smoluks/LCM3/docs/PCB/06_beultetve_drotozva.jpg

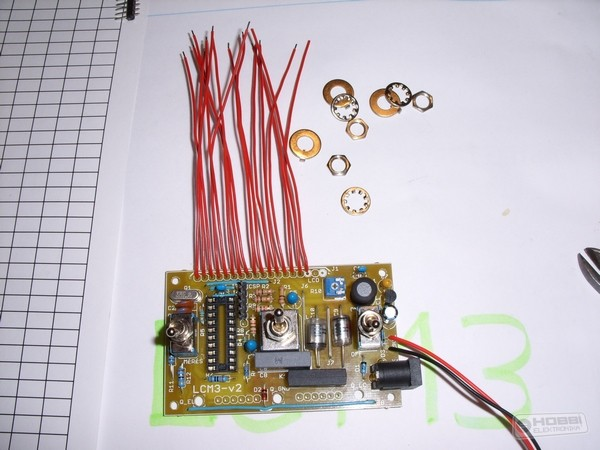
docs/PCB/06_beultetve_drotozva.jpg
