smoluks/LCM3/docs/photos/felul1.jpg

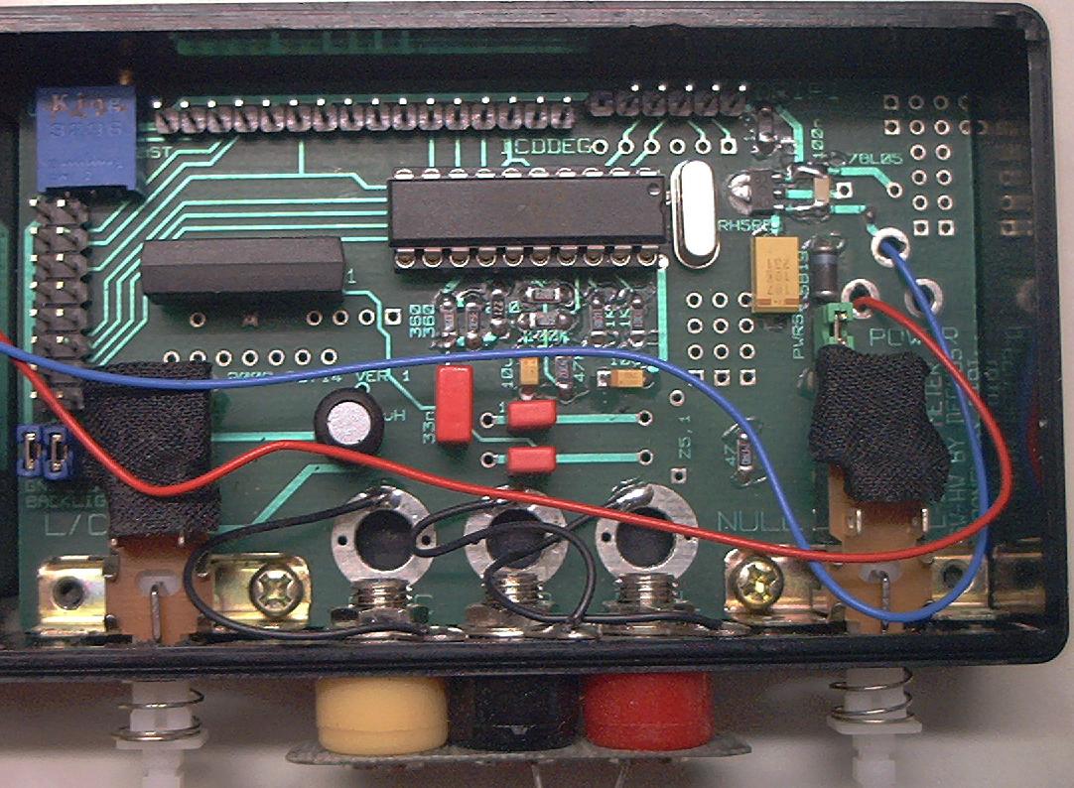
docs/photos/felul1.jpg
