smoluks/LCM3/README.md

# LCM3

Diptrace sch and pcb for Hungarian LC meter LCM3:
http://www.hobbielektronika.hu/kapcsolasok...seg_oldal1.html

Ru resource:
https://vrtp.ru/index.php?showtopic=19662&st=0
