smoluks/LCM3/atmega8/clone_schw.jpg

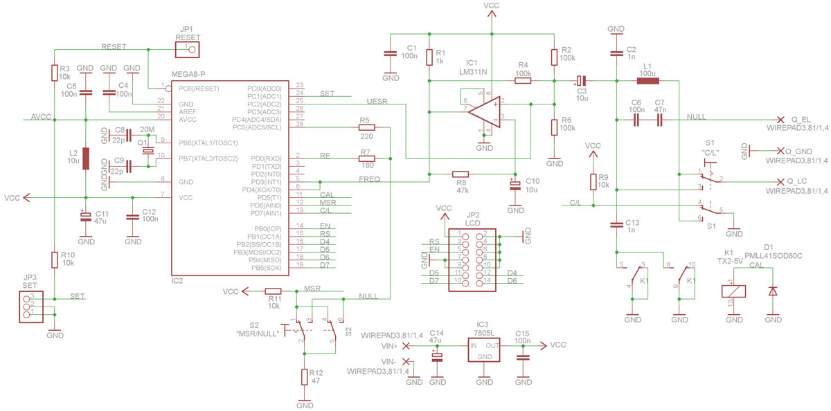
atmega8/clone_schw.jpg
