smoluks/LCM3/docs/275084828fd753a48701ff6f67b9c99d.jpg

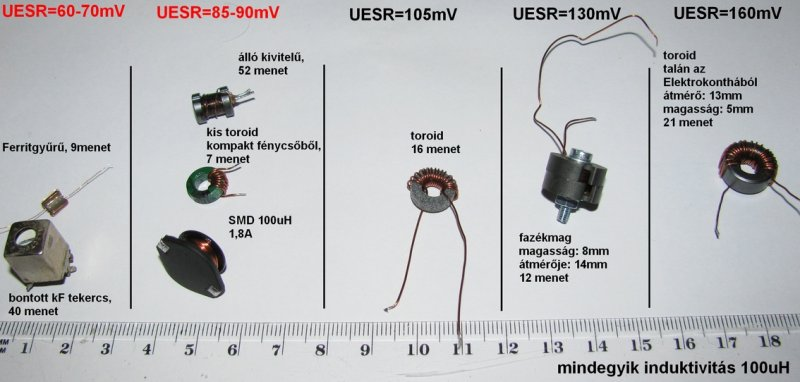
docs/275084828fd753a48701ff6f67b9c99d.jpg
