smoluks/LCM3/docs/analiz_snimok1.jpg

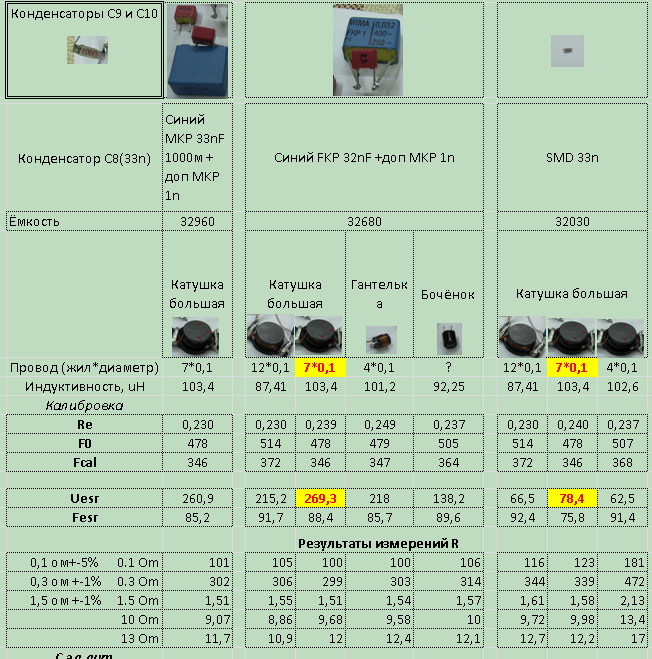
docs/analiz_snimok1.jpg
