smoluks/LCM3/docs/analiz_snimok2.jpg

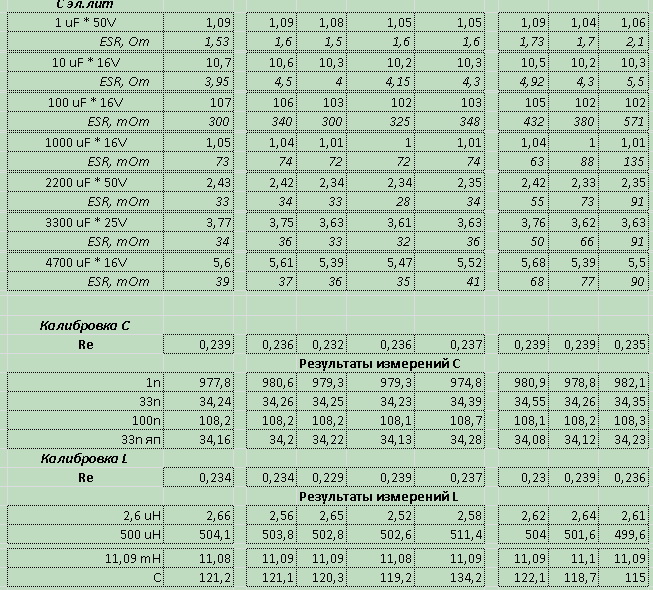
docs/analiz_snimok2.jpg
