smoluks/LCM3/docs/capacitor_value_vs_temperature_chart.gif

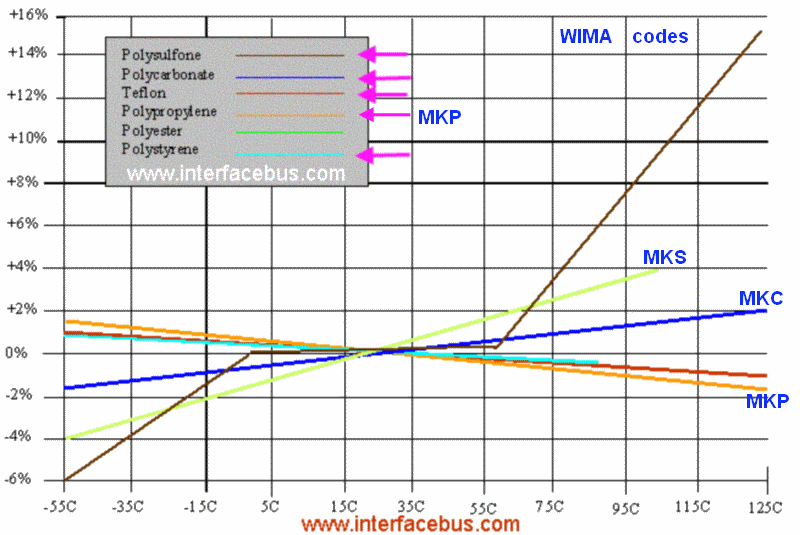
docs/capacitor_value_vs_temperature_chart.gif
