smoluks/LCM3/docs/lcm3_incircuit.png

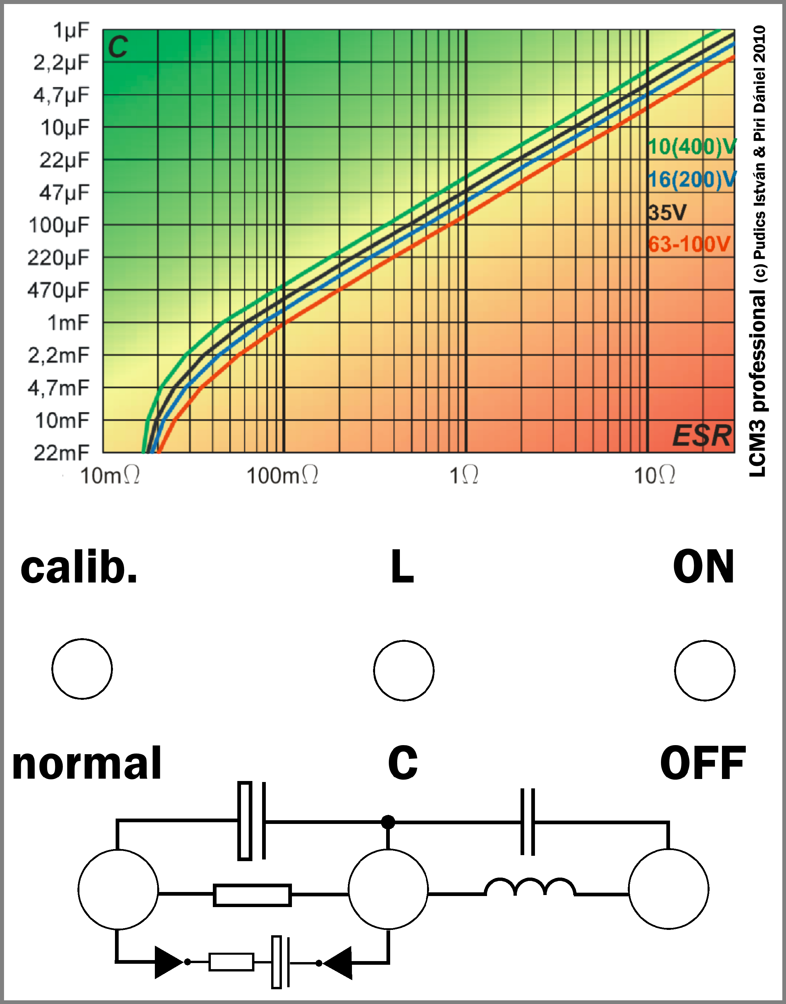
docs/lcm3_incircuit.png
