smoluks/LCM3/docs/PCB/00_nyak_elol.jpg

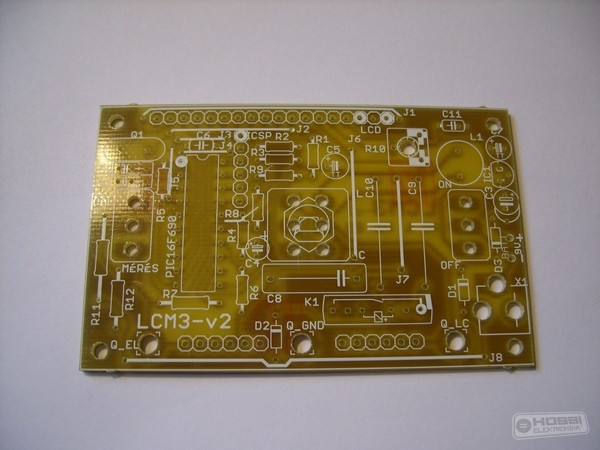
docs/PCB/00_nyak_elol.jpg
