smoluks/LCM3/docs/PCB/01_nyak_hatul.jpg

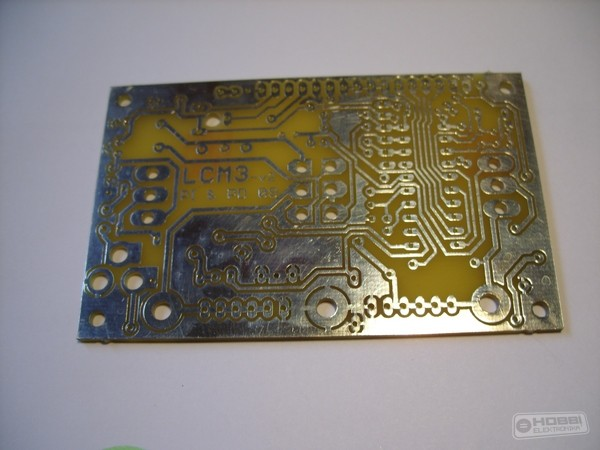
docs/PCB/01_nyak_hatul.jpg
