smoluks/LCM3/docs/PCB/lcm3_v2_board_sol.png

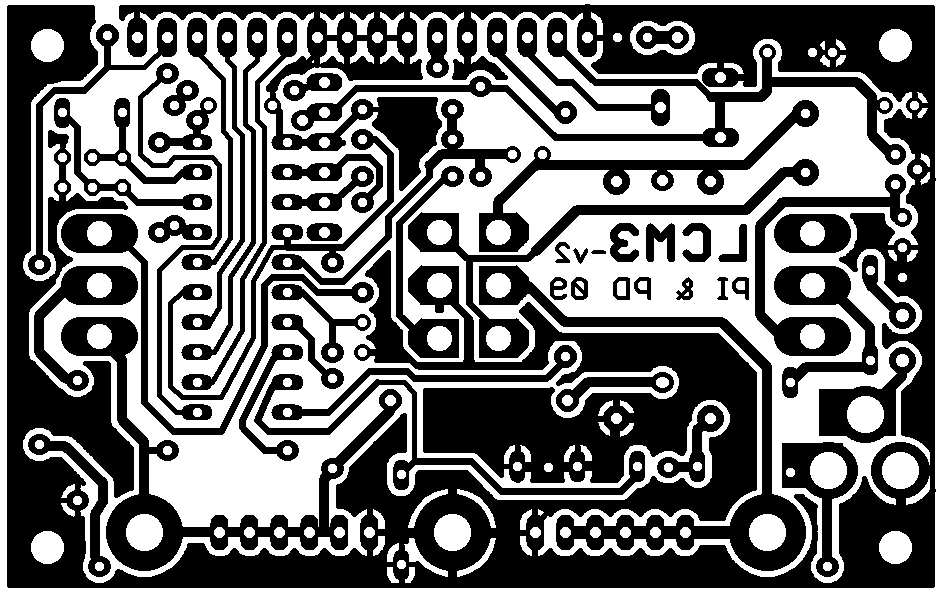
docs/PCB/lcm3_v2_board_sol.png
