smoluks/LCM3/docs/photos/12_bananhuvely_felul.jpg

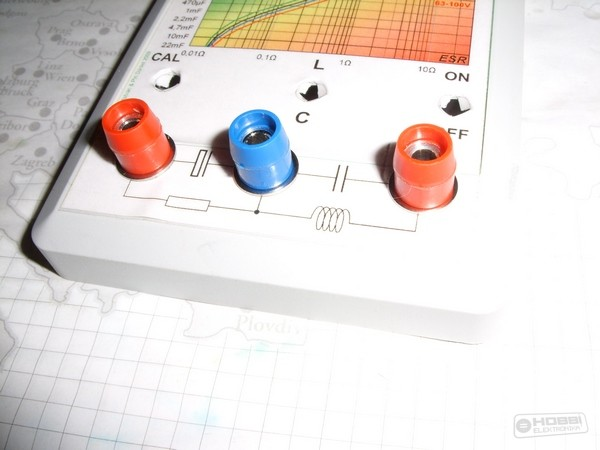
docs/photos/12_bananhuvely_felul.jpg
