smoluks/LCM3/docs/photos/14_reszlet_felfekszik.jpg

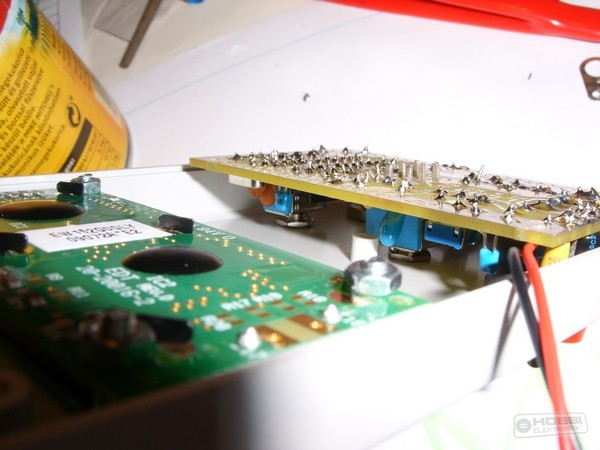
docs/photos/14_reszlet_felfekszik.jpg
