smoluks/LCM3/docs/photos/22_elem (1).jpg

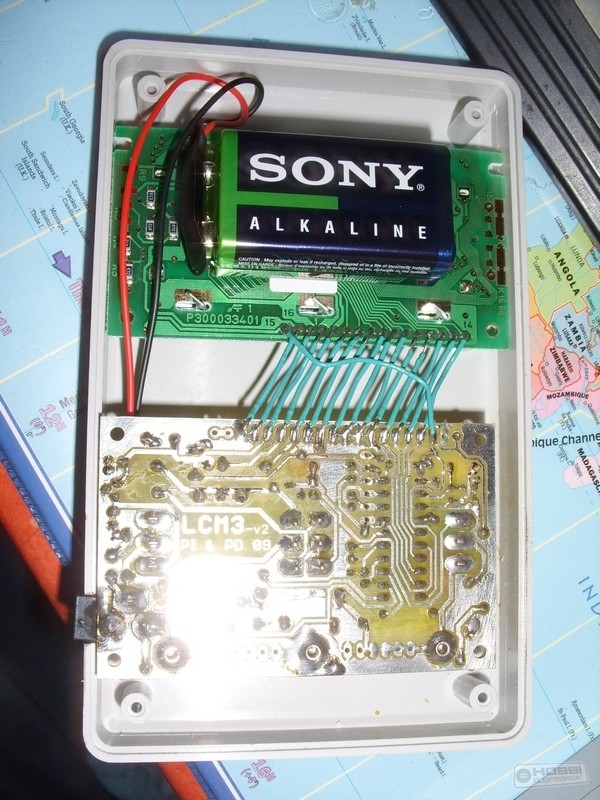
docs/photos/22_elem (1).jpg
