smoluks/LCM3/docs/photos/alul.jpg

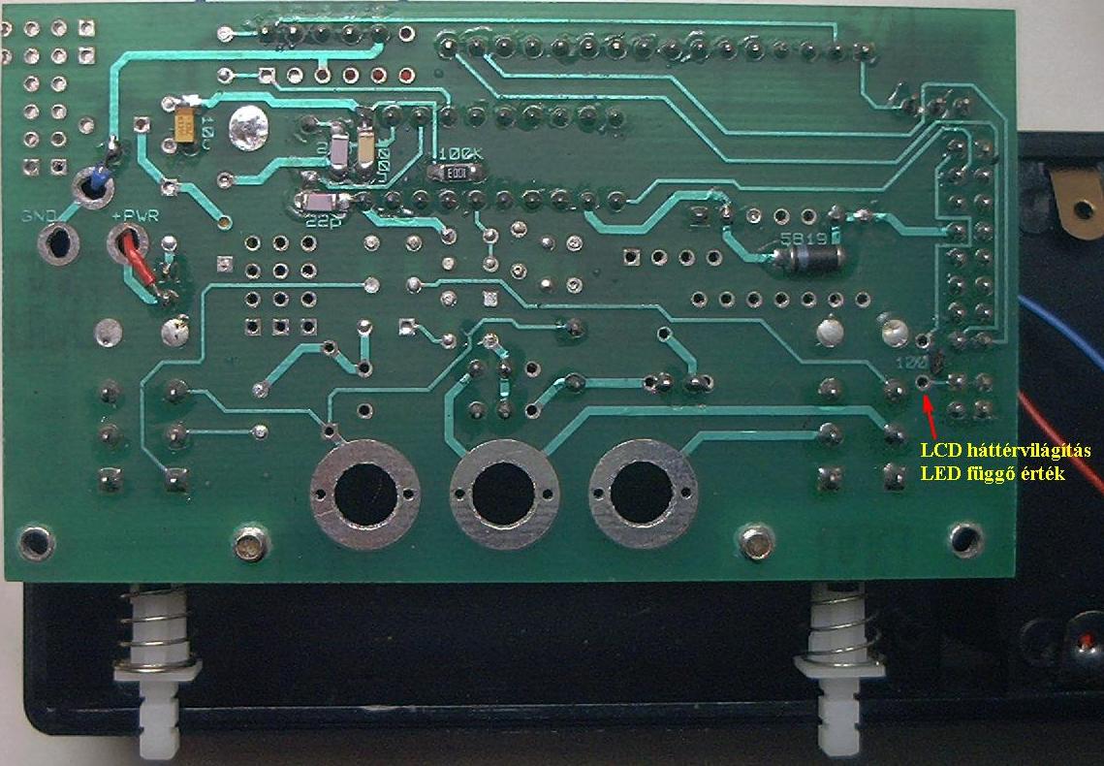
docs/photos/alul.jpg
