smoluks/LCM3/docs/photos/c_2003pf.jpg

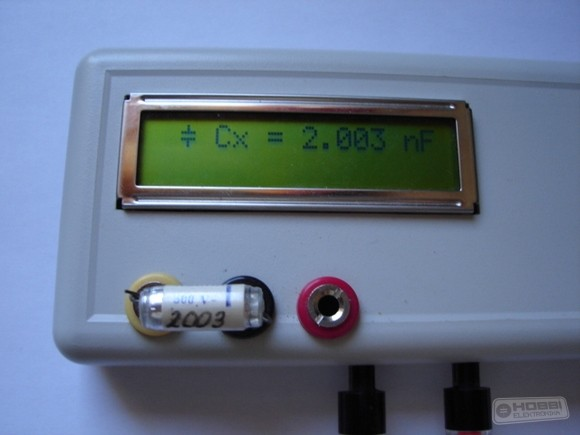
docs/photos/c_2003pf.jpg
