smoluks/LCM3/docs/photos/dobozban.jpg

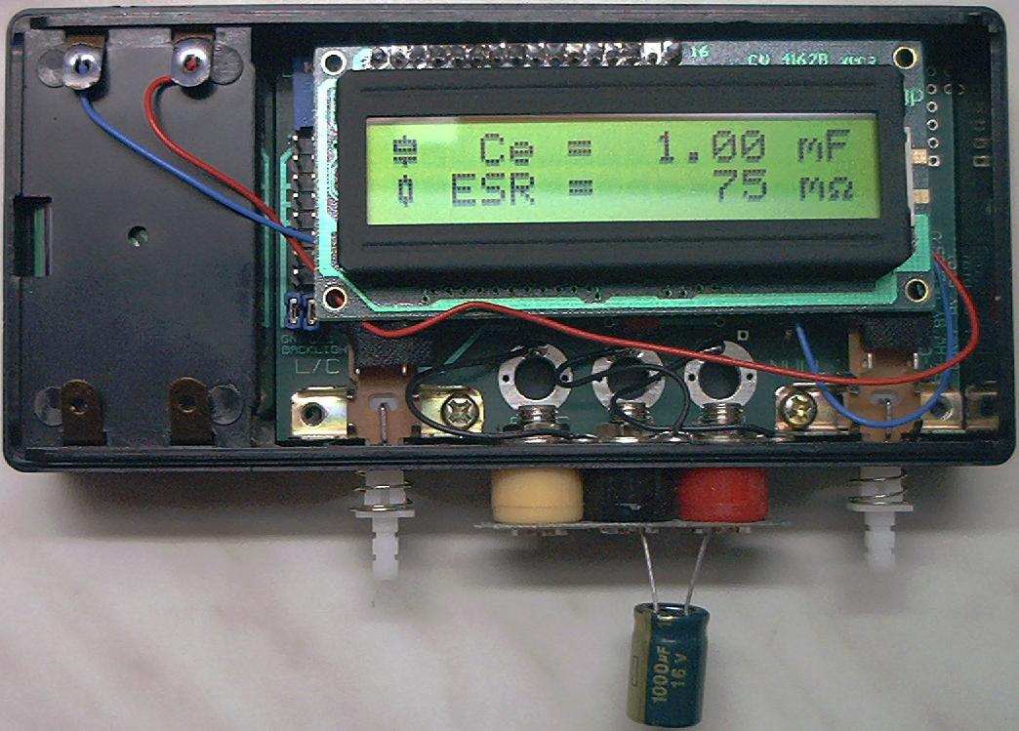
docs/photos/dobozban.jpg
