smoluks/LCM3/docs/photos/esr_tablazat.jpg

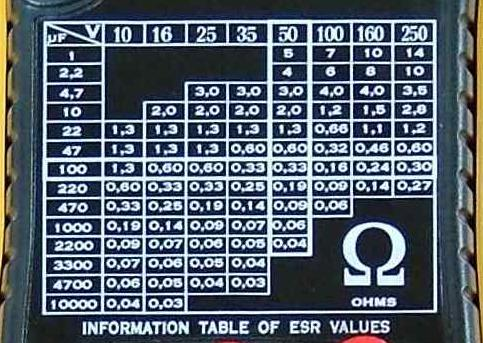
docs/photos/esr_tablazat.jpg
