smoluks/LCM3/docs/photos/felul2.jpg

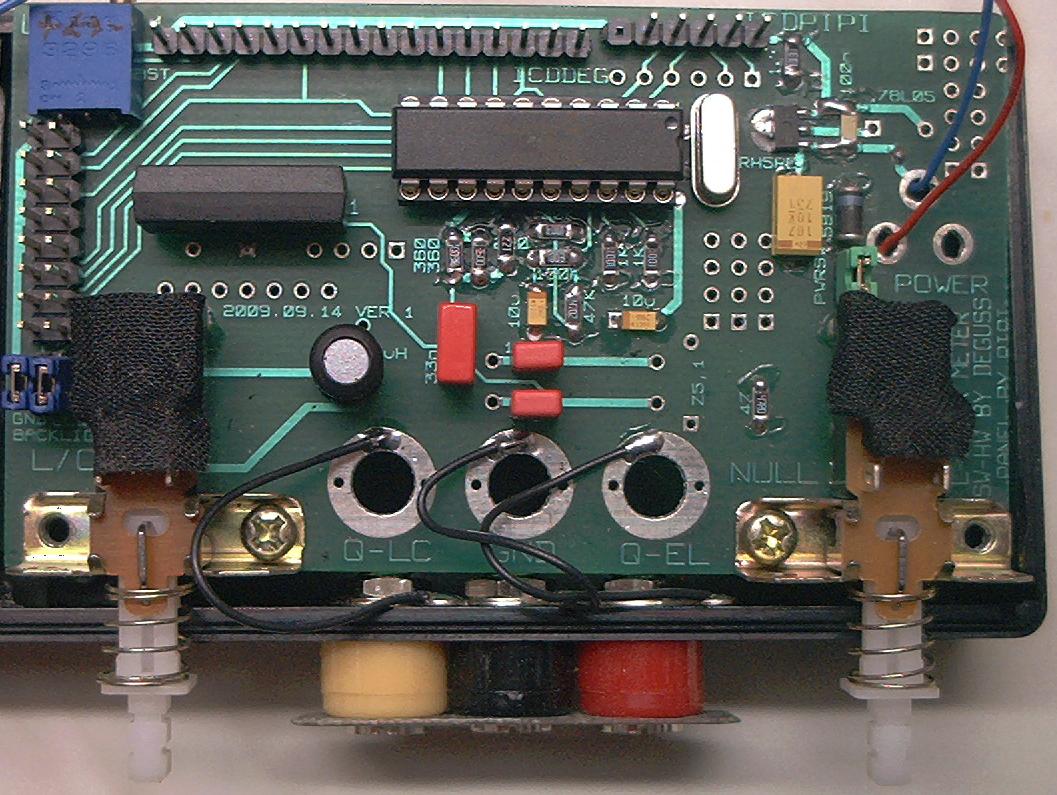
docs/photos/felul2.jpg
