smoluks/LCM3/docs/photos/mer_cp.jpg

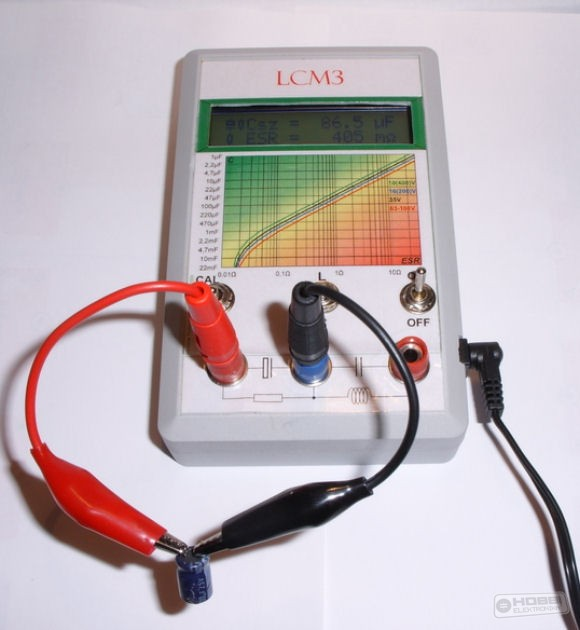
docs/photos/mer_cp.jpg
