smoluks/LCM3/docs/photos/oldal.jpg

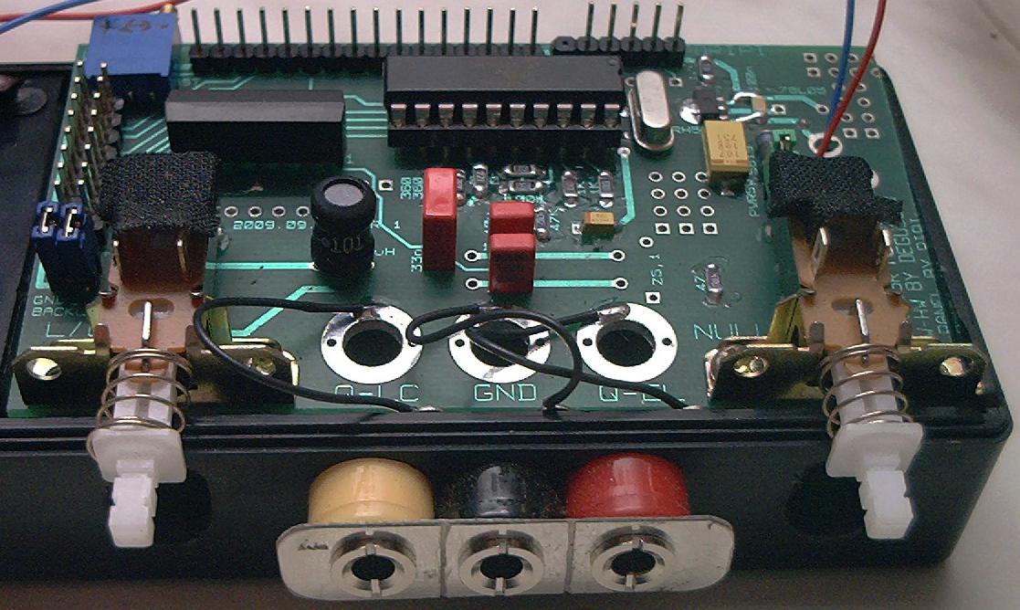
docs/photos/oldal.jpg
