smoluks/LCM3/docs/post-39-1330203417.jpg

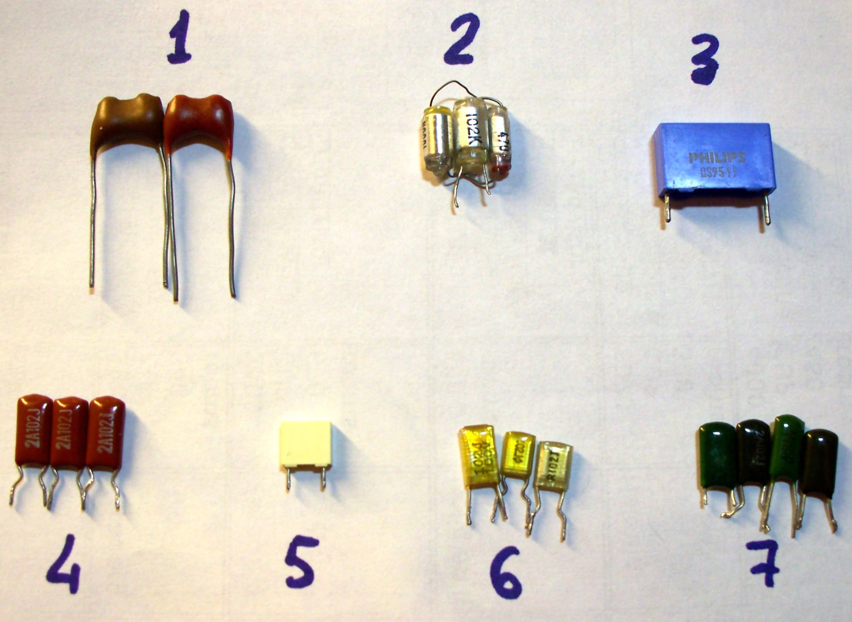
docs/post-39-1330203417.jpg
