smoluks/LCM3/docs/post-39-1334311889.jpg

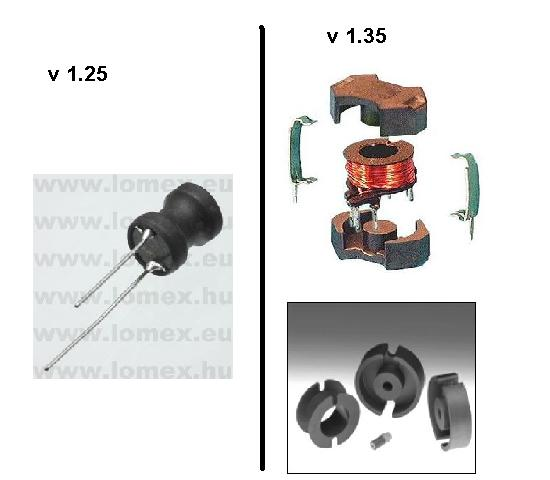
docs/post-39-1334311889.jpg
