smoluks/LCM3/docs/sch/Esr16F690BRD.gif

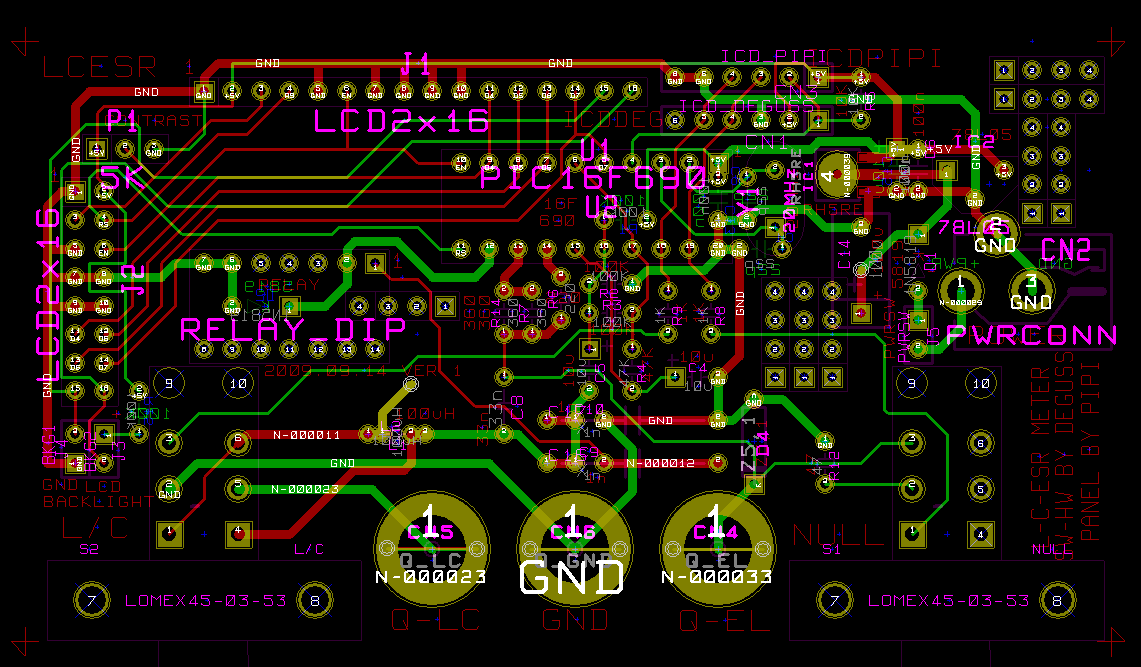
docs/sch/Esr16F690BRD.gif
