smoluks/LCM3/docs/sch/Esr16F690SCH.gif

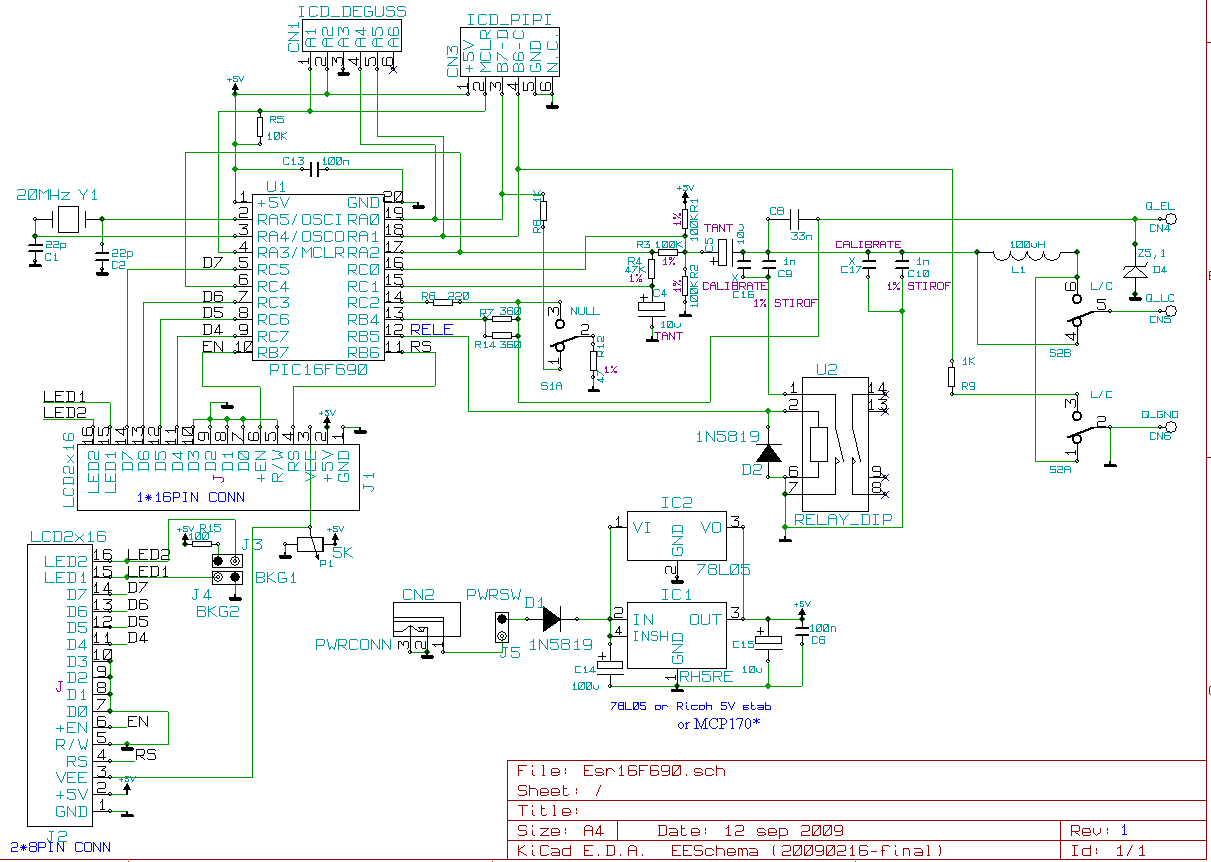
docs/sch/Esr16F690SCH.gif
