smoluks/LCM3/docs/sch/lcm3_v2_sch.png

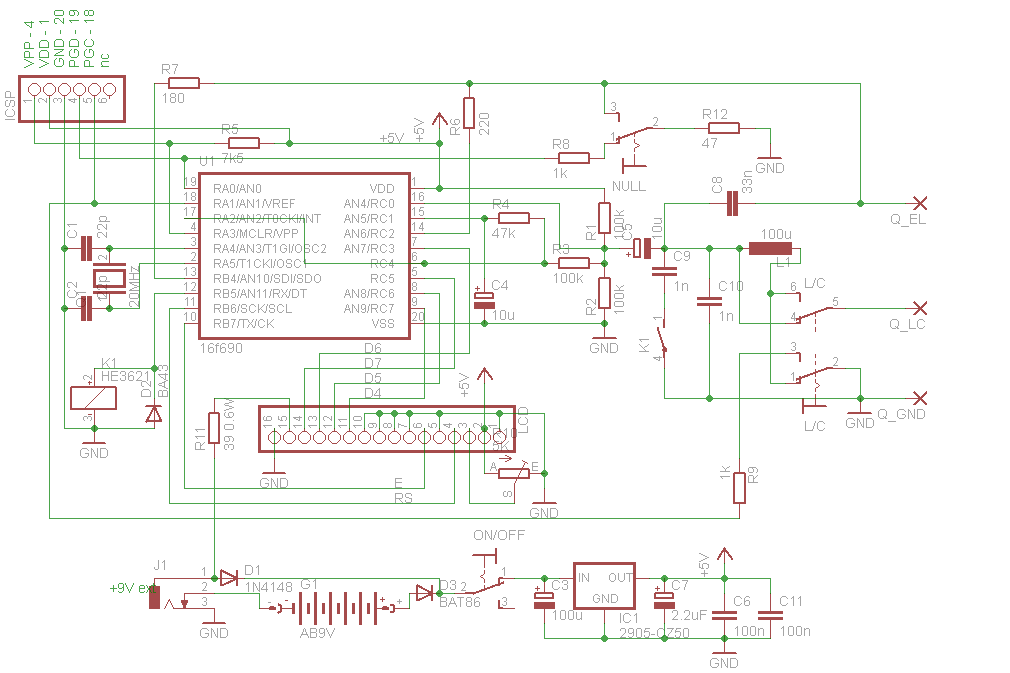
docs/sch/lcm3_v2_sch.png
