smoluks/LCM3/docs/sch/post-39-1329419530.jpg

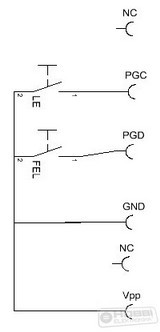
docs/sch/post-39-1329419530.jpg
