smoluks/LCM3/docs/sch/schematic_v1_eredeti.png

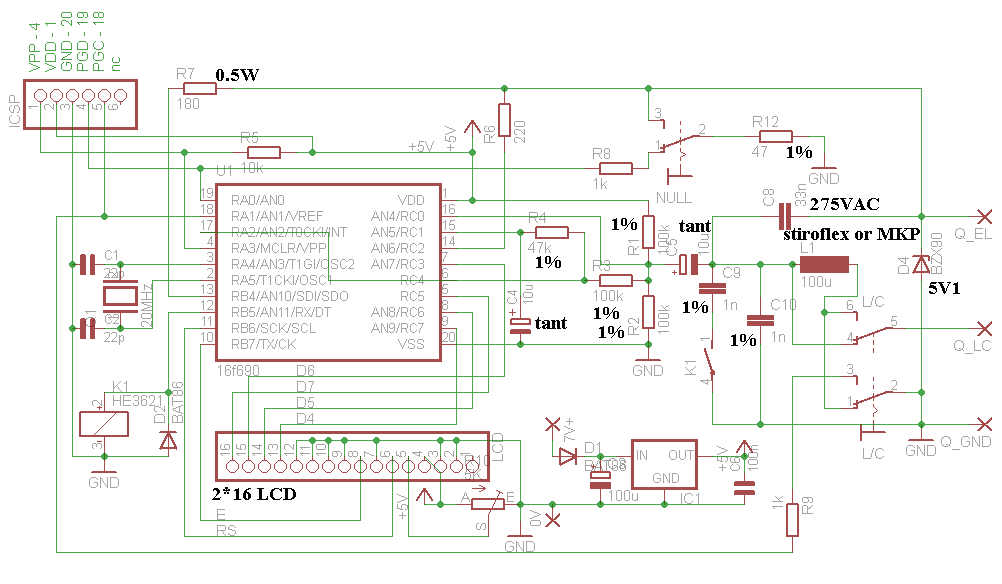
docs/sch/schematic_v1_eredeti.png
