smoluks/LCM3/docs/manuals/HU_LCM3v2.2.pdf

Használati utasítás | LCM3 v2 | 1

# LCM3

Az LCM3 egy mér
ı

m

őszer, mely segítségére lehet elektronikai alkatrészek megmérésében. Használata sokoldalú, különféle mérési feladatok ellátásánál tehet jó szolgálatot. Kezdve a tervezést

ıl, | a | min

ıségellen

ırzésen | és | alkatrészek
beazonosításán át a hibakeresésig. Az LCM3 egyben asztali m

őszer is, mivel m

őködtethet

ı dugasztápról is, megvilágított kijelz

ıvel. A gondos tervezésnek valamint a speciális alkatrészeknek köszönhet

ıen sokáig pontos, ismételhet
ı
méréséket lehet vele végezni, széls

ıséges körülmények között is.

A m

őszer paraméterei
- Kapacitásmérés 0,1pF-tól 0,1F-ig, (hitelesítés után 0,1pF-200nF között 1% pontosság egyébként e felett is 2,5%). Két tartományban: a jobb oldali csatlakozón 1uF-ig, a bal oldalin 500nF-tól.
- Induktivitásmérés 10nH-t
ıl 20H-ig, hitelesítés után 5%.
- Elektrolit kondenzátorok soros veszteségi ellenállását (ESR), illetve bármilyen kis ellenállást (<30 Ohm) mér, 5 ezred Ohm felbontással, (hitelesítés után 5% 500mOhm alatt, e felett 10%).
- E mellett képes egy tekercs (kb. 2-90mH) kapacitásának megmérésére is az induktivitás folyamatos mérése közben, és még pár apróságra, mint pl. szivárgó vagy zárlatos kondenzátorok felismerésére…

M

őködés, használat

Kapcsoljuk be a m

őszert. Ha tekercset szeretnénk mérni, váltsuk át a középs

ı kapcsolót L módba. Ellen

ırizzük, hogy közel 0 pF
illetve 0 uH (induktivitás mérésnél rövidre zárt bemenet esetén) a kimutatott érték. Ha nem, akkor kalibráció szükséges (lsd. lentebb). A mérend

ı alkatrészt a dobozon jelölt ábrának megfelel

ıen csatlakoztassuk a csipeszekkel. A mért értékek megjelennek a kijelz

ın.

Els

ı használatbavétel / Kalibráció

Els

ı használatbavételkor az ellenállásmérés (ESR) kalibrációja szükséges. Bekapcsoláskor a kapacitásmérés automatikusan megtörténik, de mind három módban lehet kalibrálni.

- C nullázás
Tegyük be a két mér

ıkábelt kondenzátor méréséhez, a középs

ı és a jobb oldali csatlakozókba. Váltsuk át a bal oldali CAL feliratú kapcsolót, várjunk míg megjelenik, hogy visszaválthatjuk és akkor értelem szer

ően váltsuk vissza
alaphelyzetbe (alsó állás).
A m

őszer pár diagnosztikai értéket kiír, majd rövidesen újra mérésre készen áll, és 0pF-ot fog mutatni.
- L nullázás
(Akkor fontos, ha kis induktivitásokat szeretnénk mérni <1mH) Tegyük be a két mér

ıvezetéket a tekercs
szimbólummal jelölt kivezetésekhez, és zárjuk azokat össze! A kalibráló kapcsolót váltsuk CAL állásba, és várjuk meg, míg a felirat megjelenik, majd váltsuk vissza.
- ESR nullázás
Tegyük be a két mér

ıvezetéket az ellenállás
szimbólummal jelölt kivezetésekhez, és zárjuk azokat össze, ügyelve a szoros érintkezésre. Ajánlott a mindkét csipeszt egy mérend

ı alkatrésze egy azon lábára, szorosan egymás mellé csíptetni, így várhatóan méréskor is közel egyforma átmeneti ellenállások lépnek majd fel, és pontosan tudunk vele mérni. Nagyon fontos, hogy helyes értékkel (max +/- 10mOhm) mentsük el a rövidre zárt

Használati utasítás | LCM3 v2 | 2

mérıvezetéket, különben minden további ellenállásmérés
hamis lesz.
Ha a kalibrálás végével nem közel nullát mutat a rövidre
zárt vezetékekkel, akkor ismételjük meg a kalibrációt. Természetesen ezeket az értékeket megjegyzi a mőszer kikapcsolás vagy elemcsere után is.

A kalibráló kapcsoló visszaváltása után, mindenképpen várjunk addig az alkatrész mérésével, amíg nem jelenik meg a kijelzın újra a mért érték, ideális esetben 0.

Nem ajánlott …

- Feszültség alatt lévı alkatrészeket mérni.
- Ismeretlen feszültségre töltött, (vagy töltıdött) kondenzátorokat csatlakoztatni. (ki kell sütni!)
- Külsı feszültséget vezetni a mőszerbe.
- Hosszú mérıvezetékeket használni.
- Olcsó, megbízhatatlan elemet behelyezni, mivel a vacak kifolyik egy pár év után és szétmarja a mőszert.

A mőszer sztatikus feltöltıdésre érzékeny alkatrészeket tartal– maz! A kijelzıt és az IC-ket csak megfelelı körülmények között, földelt fóliás asztalon, ill. kellı körültekintéssel szereljük be.

Tápellátás

A mőszer nagyon keveset fogyaszt, mindössze
8-10mA-t. Így egy 9V-os tartós (alkáli) elemrıl is sokáig mőködik. Ha szeretnénk élvezni a háttér– világítás nyújtotta elınyöket, akkor csatlakoztassunk egy 7-10V közötti egyenirányított tápegységet.

A csatlakozó polaritásvédett, 5.5 / 2.1mm átmérıjő dugóval használható.
(Ha valaki 12V-os tápegységet szeretne használni, cserélje R11-et 39Ohmról legalább 50Ohm/1W-ra, megelızve a háttérvilágítás túlhajtását; egyébként minden más maradhat max. 15V tápfeszültségig).

ESR-Diagramm értelmezés

Az elektrolit kondenzátoron feltüntetett kapacitásértéket felvisszük a vertikális tengelyre (C) és a mőszer által mért ESR értéket pedig a horizontális logaritmikus (ESR) tengelyre, majd megnézzük hova esik ezek metszéspontja.

Ha zöld zónában van, akkor kiváló (Low ESR) kondenzátorral van dolgunk, ha a pirosban, akkor egyértelmően rossz. Ha sárga zónában van a metszéspont, akkor átlagos veszteségő a kondenzátor, ha rendelkezésre áll adatlap, vessük össze az ott feltüntetett határértékkel a mért értéket. A diagramm csak irányadó, nem igazodhat az összes kapható kondenzátorhoz.

In-Circuit mérıfeltét

Ezzel a mérıvezetékbe épített áramkörrel panelba ültetett elektrolit kondenzátorok veszteségeit mérhetjük kiforrasztás nélkül. A mérıfeszültség nem több 30mV-nál, így szinte bárhol lehet vele mérni. Ez is a csomag tartalma!

Beszerzés: www.hestore.hu/termek_10028428.html Származási hely: Magyarország
Kérem vegye figyelembe a következı oldalakon található beültetési és összeszerelési útmutatót is.

Sok sikert a mőszer használatához!

+_

Összeépítési útmutató | LCM3 v2 | 3
jelölés | darab | megnevezés | OK?
| 1 | mőszerdoboz, el
ılappal, LCD-vel, 4 csavar
| 1 ónozott, fúrt, feliratozott NYÁK
U1 | 1 | felprogramozott PIC16F690
R1, R2, R3 | 3 | 100 k W-os s ellenállás 0.6W / 1%
R4 | 1 | 47 k W-os ellenállás 0.4W / 1%
R5 | 1 | 7.5 k W-os ellenállás 0.4W / 5%
R6 | 1 | 220 W-os ellenállás 0.6W fémr. /1%
R7 | 1 | 180 W-os ellenállás 0.6W fémr. /1%
R8, R9 | 2 | 1 k W-os ellenállás 0.6W / 5%
R11 | 1 | 39 W-os ellenállás 0.6W
R12 | 1 | 47 W-os ellenállás 0.6W fémr. /1%
mér ıv. | 1 | 22 W-os ellenállás 0.6W fémr./1%
R10 | 1 | 10 k W-os trimmerpotenciométer
D1, D2 | 1 | 1N4148-as dióda (üvegházas)
D3 + mér ıv. | 1+2 | BAT46-os dióda (kék)
mér ıv. | 1 | 1uF WIM
C1, C2 | 2 | 22pF-os kerámiakondenzátor (22)
C3 | 1 | 220uF-os elektrolit kondenzátor
C4, C5 | 2 | 10uF/16V tantál polarizált !
C6, C11 | 2 | 100nF-os kerámiakondenzátor (104)
C7 | 1 | 2.2uF/25V tantál polarizált !
C8 | 1 | 33nF, kis veszteségő MPK
C10 | 1 | 1nF, 2%, kis h ıfokfügg ı stiroflex
C9 | 1 | 1nF, bemért 0.5%-os stiroflex, jelöléssel
L1 | 1 | 100uH, radiális induktivitás
IC1 | 1 | „low drop” feszültségstabilizátor TS2950-5.0
X1 | 1 | DC tápcsatlakozó (5.5/2.1)
Q1 | 1 | 20MHz-es alacsony kivitelő kvarc
K1 | 1 | R1-1A0500; SIL tokozású reed relé
L/C | 1 | két áramkörös, kétállású billen ıkapcsoló
NULL,
ON/OFF | 2 | egy áramkörös, kétállású billen ıkapcsoló
| 2 banándugó (piros és fekete)
| 3 banánhüvely beköt | ı dróttal
| 2 krokodilcsipesz (piros és fekete)
BAT | 1 | 9V-os elemcsatlakozó
| 2 mér | ıvezetékek
| 1 75cm szigetelt drót az LCD-hez
| 2 zsugorcsövek (d6*15mm)
| 1 nyomtatott útmutató és beültetési segédlet

Összeépítési útmutató

1. Készítsünk átkötéseket szigetelt drótból. Átkötések, ellenállások beültetése.
2. Diódák, kondenzátorok, kvarc, potméter, IC-k, kapcsolók, elemcsatlakozó és a többi alkatrész beültetése, emelked
ı
magasságban mindet. A kapcsolókról csavarjuk le a fels
ı
anyát, és az alsókat állítsuk egy magasságba.
Ügyeljünk a diódák katódcsíkjára, a relé elhelyezésére (felirat a kondenzátorok felé néz), valamint a tantál elkók polaritására. Az X1 csatlakozót és a kapcsolókat rövid ideig, de

b

ıséges
ónnal forrasszuk!
3. Készítsünk 16 rövid (3.5cm) vezetékdarabkát, és még most forrasszuk egyik végüket az LCD feliratú fels

ı furatsorba, úgy,
hogy a balról számított els

ı és második furat kimarad.

Pontosan az alkatrészlista alapján járjunk el, egy hibásan, vagy rossz helyre beültetett alkatrész károsíthatja a többit, legrosszabb esetben tönkre is teheti a mikrovezérl

ıt.

Összeépítési útmutató | LCM3 v2 | 4

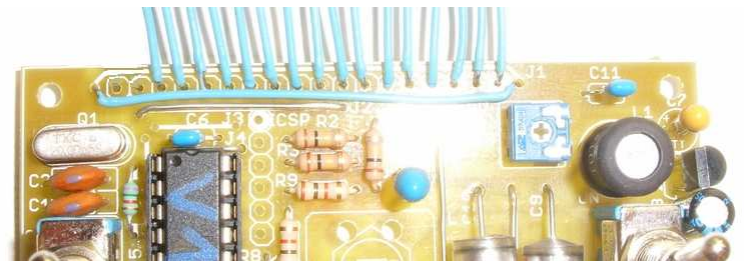
[picture p30: figure]

4. Szereljük rá a mőszerdobozra a banánhüvelyeket. A banánhüvelyek felfogatása belülrıl történik, de elıtte a lemezkékhez a bekötıvezetéket hajlítsuk meg. Az anyákat illik meghúzni, de nem túlhúzni.
5. Tegyük be a nyákot a dobozba. A kapcsolókra az alátétet, és az anyát rátéve, azokat finoman meghúzva igazgassuk a helyére. A kapcsoló anyáit villáskulccsal húzzuk meg!
6. Végül a kijelzıhöz való forrasztást végezzük el. Szépen sorjában. A piros nyilak az elsı beforrasztandó helyét jelölik.

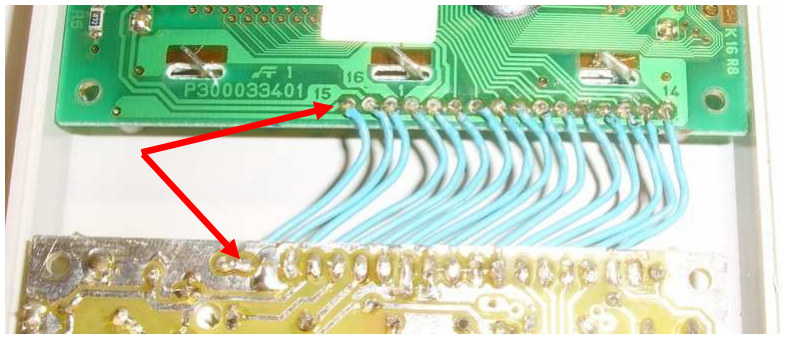
[picture p31: figure]

7. A megfelelı mőködés érdekében a nyákot és a kijelzı csatlakozósor részét meg kell tisztítani. Mechanikus (finom drótkefe) és vegyi úton (benzin, denaturált szesz). Tisztítás után lehet a nyákot konzerválni, de ennek hiányában ne nyúljunk hozzá többet puszta kézzel (zsírosodás).
8. Ha minden alkatrészt beültettünk, és mindent helyesen bekötöttünk, akkor elemrıl vagy tápról járatva, kapcsoljuk be a mőszert. Az LCD-n csak akkor lesz olvasható a kijelzett szöveg, ha beállítjuk a kontrasztot. (R10).
9. ÚJDONSÁG: InCircuit-mérıfeltét
Ennek segítségével áramkörön belül mérhetünk veszteséges kondenzátorokat.

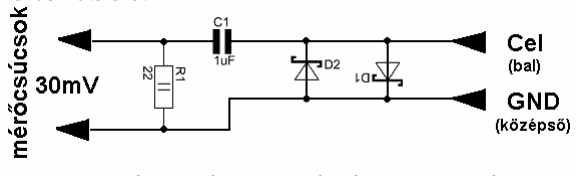
[picture p32: figure]

A csomagolt mérıvezeték csatlakozóit vágjuk le 12cm-nél. Vágjunk le a mérıtüskék felıli végébıl egyenként legalább újabb 12cm-t, ez lesz majd a mérıvezeték a normál mérésekhez. Most a megrövidített mérıvezetékek és a mérıcsatlakozókat kössük össze a fenti kapcsolással. A kondenzátor nem polarizált, viszont érzékeny a túlzott hevítésre, mint ahogy a shottky diódák is. A csatlakozásokat elıbb sodorjuk össze, majd csak utána forrasszuk le. A zsugorcsöveket ne felejtsük felhúzni a vezetékekre még forrasztás elıtt!
Aki úgy gondolja, hogy nem boldogulna a mérıvezeték, vagy a mőszer összeállításával, írjon nyugodtan e-mailt, a készlet erejéig szerelünk is össze belılük.

További kérdéseit szívesen megválaszoljuk, ha azokat elküldi a deguss@hobbielektronika.hu levélcímre.

Sok sikert a mőszer használatához!
