smoluks/LCM3/docs/PCB/lcm3_v2_board_sol.pdf

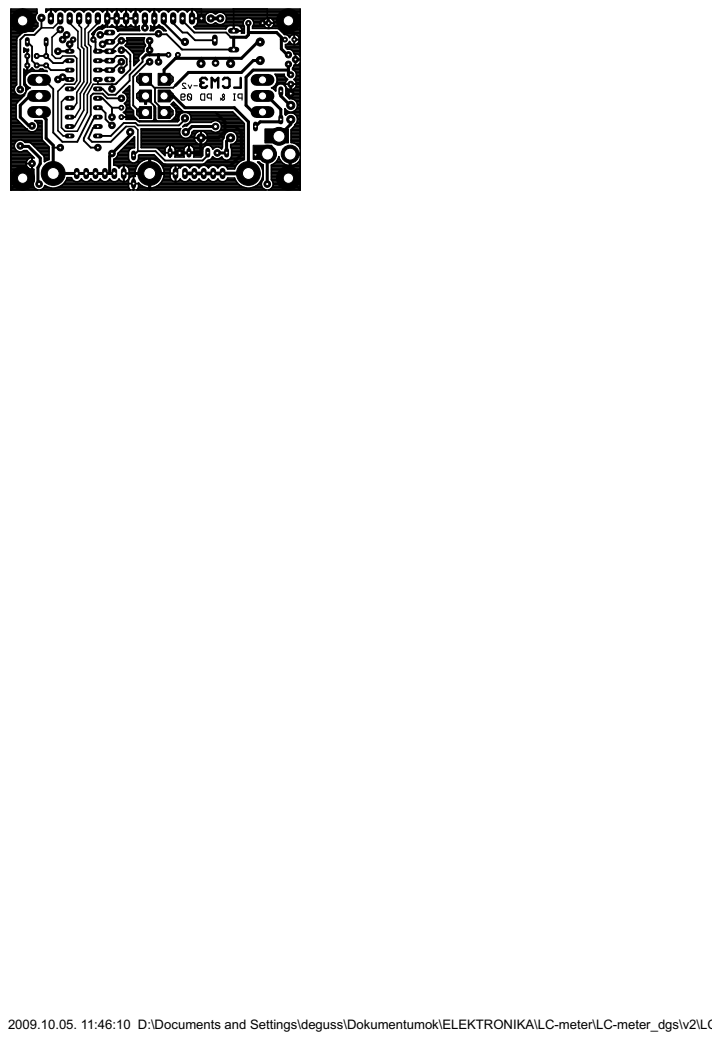
[picture p33: page 1]

2009.10.05. 11:46:10 D:\Documents and Settings\deguss\Dokumentumok\ELEKTRONIKA\LC-meter\LC-meter_dgs\v2\LCM3_v2.brd
