smoluks/LCM3/(list of files, drawings)

Other design files:
docs/PCB/2012_04_11_hun_LCM3_ANK_razvodka.LAY
docs/PCB/hun_LC_ESR_10_29_2011.LAY
docs/PCB/Hungarian_LC_ESR_Meter_03_04_2012_Ruslan_V2.LAY
docs/PCB/LCM3.LAY1.LAY
docs/PCB/LCM3_v2.lay
docs/PCB/LCM3mew.lay
docs/PCB/Vengerskiy_C_L_ESR.lay
front panel.dip
lcm3.dch
lcm3.dip
lcm3_lut.dip
